eprive/Z80-MBC3/MBC2512.ods

Source: | MBC2512 Rev 3A
Date: | 14-4-2021
Tool: | Eeschema (5.1.4)-1
Ref | Value | Footprint
A1 | 20k | Potentiometer_THT:Potentiometer_Alpha_RD901F-40-00D_Single_Vertical
B1 | Piezo | Buzzer_Beeper:Sounder_17mm
C1 | 0.1uF | Capacitor_THT:C_Disc_D5.0mm_W2.5mm_P5.00mm
C2 | 0.1uF | Capacitor_THT:C_Disc_D5.0mm_W2.5mm_P5.00mm
C3 | 0.1uF | Capacitor_THT:C_Disc_D5.0mm_W2.5mm_P5.00mm
C4 | 0.1uF | Capacitor_THT:C_Disc_D5.0mm_W2.5mm_P5.00mm
C5 | 100uF | Capacitor_THT:CP_Radial_D6.3mm_P2.50mm
J1 | ANIN | Connector_PinHeader_2.54mm:PinHeader_1x03_P2.54mm_Vertical
J2 | Serial | Connector_PinSocket_2.54mm:PinSocket_1x06_P2.54mm_Vertical
J3 | Connector_01x12 | Connector_PinHeader_2.54mm:PinHeader_1x12_P2.54mm_Vertical
J4 | ICSP | Connector_PinHeader_2.54mm:PinHeader_1x03_P2.54mm_Vertical
J5 | SD_MOD | logos:PinSocket_1x06_P2.54mm_Vertical_Module_SDM
J6 | RTC-MOD | Connector_PinSocket_2.54mm:PinSocket_1x06_P2.54mm_Vertical_RTC
J7 | Conn_01x04_Male | Connector_PinHeader_2.54mm:PinHeader_1x04_P2.54mm_Vertical
L1 | LED – RED | LED_THT:LED_D5.0mm
L2 | LED – GREEN | LED_THT:LED_D5.0mm
L3 | LED – YELLOW | LED_THT:LED_D5.0mm
Q1 | 2N3905 or 2N3907 | Package_TO_SOT_THT:TO-92_Inline
R1 | 1k | Resistor_THT:R_Axial_DIN0207_L6.3mm_D2.5mm_P10.16mm_Horizontal
R2 | 680 | Resistor_THT:R_Axial_DIN0207_L6.3mm_D2.5mm_P10.16mm_Horizontal
R3 | 820 | Resistor_THT:R_Axial_DIN0207_L6.3mm_D2.5mm_P10.16mm_Horizontal
R4 | 33 | Resistor_THT:R_Axial_DIN0207_L6.3mm_D2.5mm_P10.16mm_Horizontal
R5 | 27k | Resistor_THT:R_Axial_DIN0207_L6.3mm_D2.5mm_P10.16mm_Horizontal
R6 | - | Resistor_THT:R_Axial_DIN0207_L6.3mm_D2.5mm_P10.16mm_Horizontal
R7 | - | Resistor_THT:R_Axial_DIN0207_L6.3mm_D2.5mm_P10.16mm_Horizontal
R8 | 100 | Resistor_THT:R_Axial_DIN0207_L6.3mm_D2.5mm_P10.16mm_Horizontal
R9 | 150 | Resistor_THT:R_Axial_DIN0207_L6.3mm_D2.5mm_P10.16mm_Horizontal
R10 | 22 | Resistor_THT:R_Axial_DIN0207_L6.3mm_D2.5mm_P10.16mm_Horizontal
R11 | 22k | Resistor_THT:R_Axial_DIN0207_L6.3mm_D2.5mm_P10.16mm_Horizontal
S1 | USER | Button_Switch_THT:SW_PUSH_6mm_H5mm
S2 | RESET | Button_Switch_THT:SW_PUSH_6mm_H5mm
U1 | Z80CPU | Package_DIP:DIP-40_W15.24mm_Socket_LongPads
U2 | TC551001BPL-70 | Package_DIP:DIP-32_W15.24mm_Socket_LongPads
U3 | ATmega4809-PF2 | Package_DIP:DIP-40_W15.24mm_Socket_LongPads
U4 | PCF8574 | Package_DIP:DIP-16_W7.62mm_Socket_LongPads
 | socket DIP32
 | socket DIP40
 | socket DIP40
 | socket DIP16
 | Battery | CR2032 or LIR2032
 | micro SD card
 | USB cable
