eprive/Z80-MBC3/Rev3A-2512.pdf

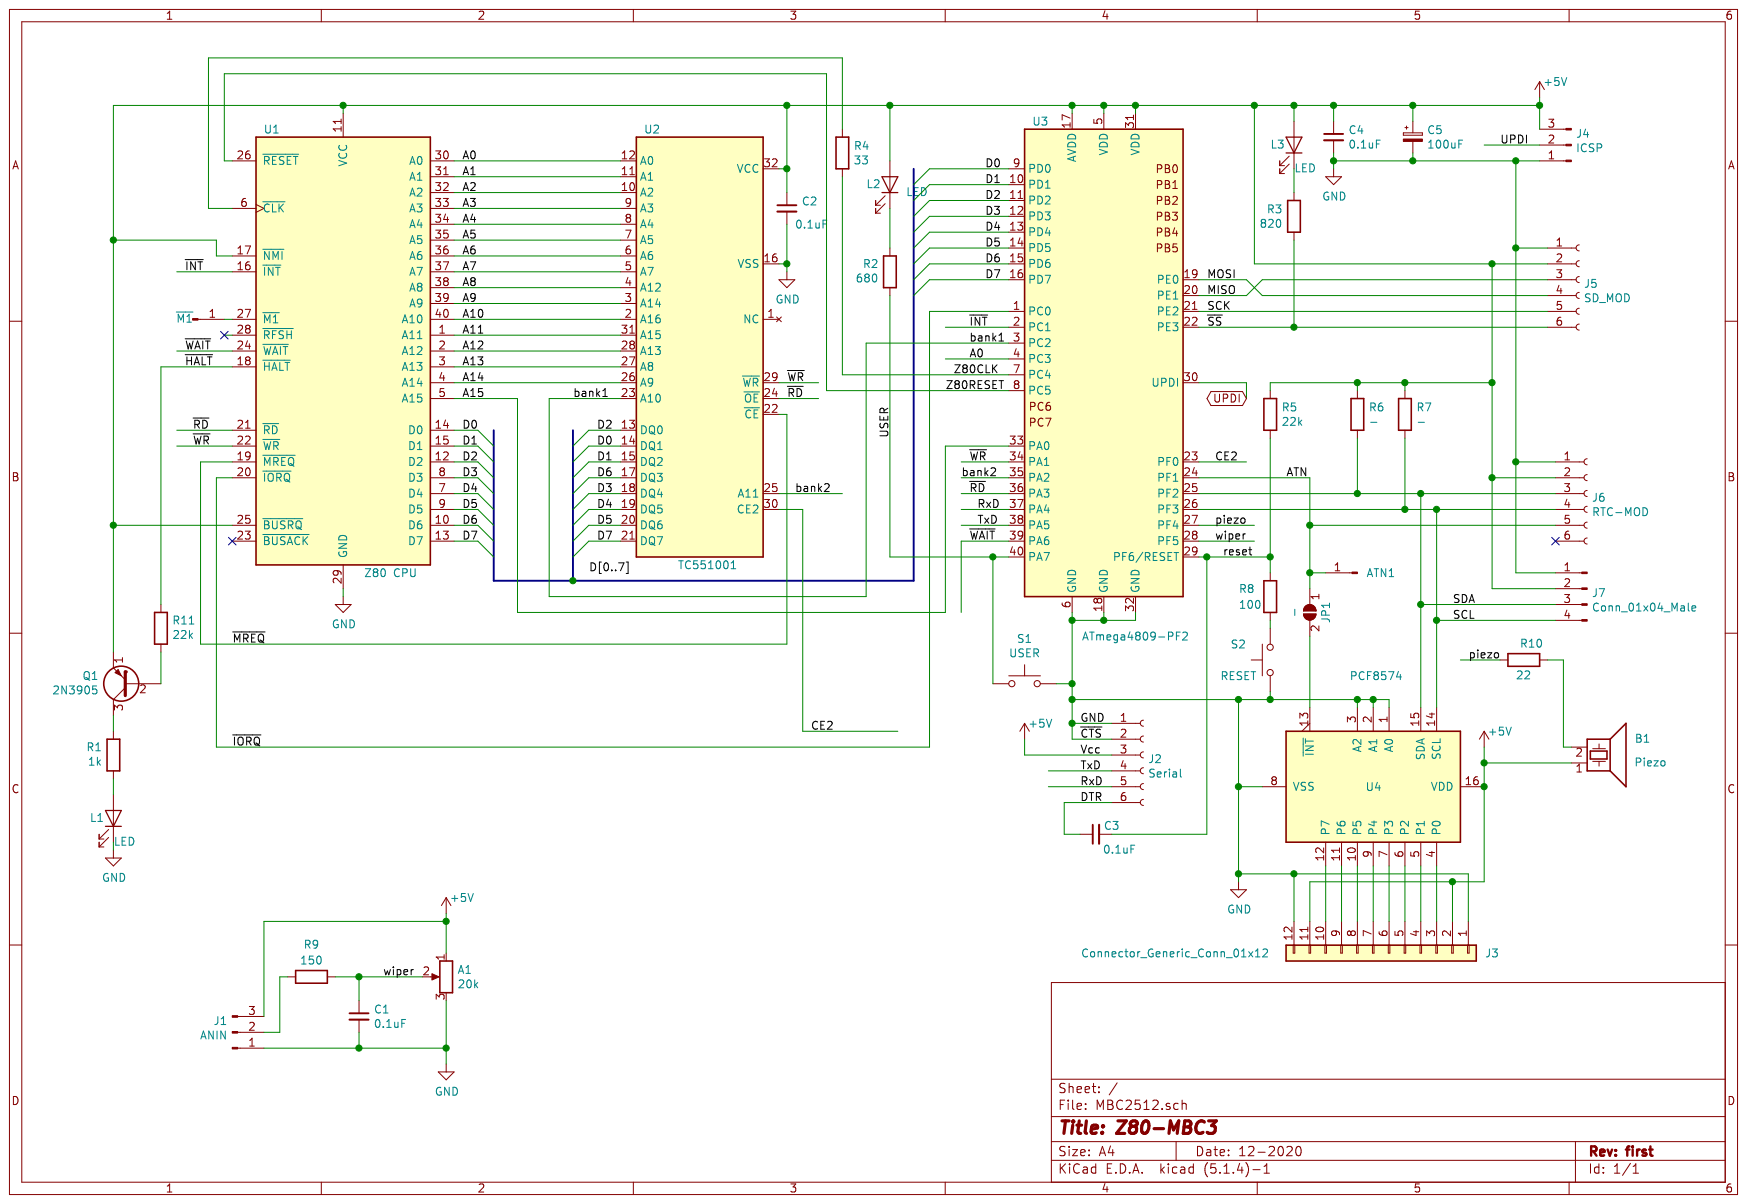
[picture p2: page 1]
