eprive/Z80-MBC3/MBC2512.sch

## KiCad design MBC2512.sch (2022-06-21, last stored version)

Schematic: MBC2512.sch

Parts:
A1: 20k; Potentiometer_Alpha_RD901F-40-00D_Single_Vertical
ATN1: PinHeader_1x01_P2.54mm_Vertical
B1: Piezo; Sounder_17mm
C1, C2, C3, C4: 0.1uF; C_Disc_D5.0mm_W2.5mm_P5.00mm
C5: 100uF; CP_Radial_D6.3mm_P2.50mm
J1: ANIN; PinHeader_1x03_P2.54mm_Vertical
J2: Serial; PinSocket_1x06_P2.54mm_Vertical
J3: Connector_Generic_Conn_01x12; PinHeader_1x12_P2.54mm_Vertical
J4: ICSP; PinHeader_1x03_P2.54mm_Vertical
J5: SD_MOD; PinSocket_1x06_P2.54mm_Vertical_Module_SDM
J6: RTC-MOD; PinSocket_1x06_P2.54mm_Vertical_RTC
J7: Conn_01x04_Male; PinHeader_1x04_P2.54mm_Vertical
JP1: -; SolderJumper-2_P1.3mm_Open_RoundedPad1.0x1.5mm
L1, L2: LED; LED_D5.0mm
L3: LED; LED_D5.0mm_YELLOW
Q1: 2N3905; TO-92_Inline
R1: 1k; R_Axial_DIN0207_L6.3mm_D2.5mm_P10.16mm_Horizontal
R2: 680; R_Axial_DIN0207_L6.3mm_D2.5mm_P10.16mm_Horizontal
R3: 820; R_Axial_DIN0207_L6.3mm_D2.5mm_P10.16mm_Horizontal
R4: 33; R_Axial_DIN0207_L6.3mm_D2.5mm_P10.16mm_Horizontal
R5, R11: 22k; R_Axial_DIN0207_L6.3mm_D2.5mm_P10.16mm_Horizontal
R6, R7: -; R_Axial_DIN0207_L6.3mm_D2.5mm_P10.16mm_Horizontal
R8: 100; R_Axial_DIN0207_L6.3mm_D2.5mm_P10.16mm_Horizontal
R9: 150; R_Axial_DIN0207_L6.3mm_D2.5mm_P10.16mm_Horizontal
R10: 22; R_Axial_DIN0207_L6.3mm_D2.5mm_P10.16mm_Horizontal
S1: USER; SW_PUSH_6mm_H5mm
S2: RESET; SW_PUSH_6mm_H5mm
U1: Z80 CPU; DIP-40_W15.24mm_Socket_LongPads
U2: TC551001; DIP-32_W15.24mm_Socket_LongPads
U3: ATmega4809-PF2; DIP-40_W15.24mm_Socket_LongPads
U4: PCF8574; DIP-16_W7.62mm_Socket_LongPads
~M1: PinHeader_1x01_P2.54mm_Vertical
