eprive/Z80-MBC3/(threads)

Thread 4 (2023-05-24):

Z80-MBC3 to assemble

hosamki, 2023-05-24:
I want to buy a Z80-MBC3 to assemble. What should I do?

hosamki, 2023-05-24:
I live in Seoul, South Korea.

eprive, 2023-05-24:
There is a webshop that is dedicated to the Z80-MBC3. You will find it here : https://eighties.company.site/

And you can choose the kit to be assembled, or a ready made and tested board.

You can use the email address ( eprive@gmx.com ) as mentioned under my account for future enquiries.

eprive

hosamki, 2023-05-30:
I tried to order on the site you told me, but it cannot be delivered to South Korea.
Why?

hosamki, 2023-05-30:
There is not South Korea (or Republic of Korea) in Country of Shipping & Delivery.

hosamki, 2023-05-30:
I sent you a email.

hosamki, 2023-05-31:
I checked that "Republic of Korea" was added to the list of countries.
So I just ordered and paid for two Z80-MBC3.
I look forward to receiving it as soon as possible.

Closed 2023-08-31.

Thread 5 (2023-06-21):

What should I do?

hosamki, 2023-06-21:
I've assembled Z80-MBC3 and tried to boot to putty, but it doesn't work. If you set it to serial mode and execute it, there is no message and it stops. What should I do?

hosamki, 2023-06-21:
![Uploading 1687353240239401466899661161486.jpg…]()

hosamki, 2023-06-21:
![Uploading 1687353296634833770379740911189.jpg…]()

hosamki, 2023-06-21:
When you connect, the blue LED flashes, but when you execute putty, it stops like this.

hosamki, 2023-06-21:
![Uploading 1687353669082373887100901091613.jpg…]()

hosamki, 2023-06-21:
Please help me!

Thread 7 (2024-05-05):

Kicad schematic lost symbol and cache

mciucci65, 2024-05-05:
Hi it's possible to have all symbol for kicad schematic or cache ?

eprive, 2024-05-05:
The complete set of Kicad design files is now in the repository at MBC2512.zip. The schematic, PCB layout, project specific items, and Gerber "plots".

Closed 2024-05-05.

Thread 8 (2024-06-01):

atmega4809 programming

mciucci65, 2024-06-01:
thanks again for uploading gerber and  etc.
I have successfully programmed the atmega4809 with Arduino Uno and Jtag2updi.
I programmed the chip 4809 with flash.bat and result is successfully programmed.
The Program compare.bat tells me that flash compared with ios hex file is ok  but when I start with a CPU Z84C0020PEC, working on MBC2,  the Halt LED turn on and nothing happens and the CPU warms up. If I start without cpu I don't see anything while with the MBC2 at least I see the boot of the mega32a chip.
I checked also with oscilloscope the cpu clock and it is 5mhz.
There is something wrong that I am doing to program the 4809 chip needing a bootloader and specific value for fuses ?

eprive, 2024-06-01:
Your question raises several other questions, MBC2 or MBC3 ? Only ATmega4809 chips that are contained in the (complete) Z80-MBC3 kit or assembled boards will function. Other (blank) ATmega4809-PF's cannot be used.
And they are unsuitable for the older Z80-MBC2. As are derivatives or attempts to clone the Z80-MBC3.

Closed 2024-06-01.

Thread 9 (2024-08-16):

Support

mciucci65, 2024-08-16:
Can you explain me better how to use external i2c bus and what is the meaning of JP1 connected to INT signal of i2c GPIO controller and share some code example ?.

Can you ask Carlo Consoli to share the code for LCD display?

Is it possible to share the sketch? I want to implement a status display controlled by i2c bus.

eprive, 2024-08-16:
The way to use the I2C bus with the Z80-MBC3 is described in the application note : AN-GPIOandI2C.pdf

The on board PCF8574 is fixed at adress 0x20. External expansion with additional PCF8574 or MCP23017 should be set at other unique addresses. Standard LCD modules are available which have their own PCF8574 on a piggyback addon.
JP1 is unconnected and not used. It would be possible to have external interrupts when needed for customised applications.

I understand that Carlo Consoli has shared his code and I can ask him to post it on the Facebook group page or email it to you. This applies to all sample code created by Z80-MBC3 users.

The Z80-MBC3 is not an Arduino compatible board but one for Z80 applications, and DIY assembly of a single board computer. The ATmega4809 IOS controller currently does not implement a "sketch" as was the case with the Z80-MBC2.

In answer to you last note : If your type of application is a simple status display, or one with a GPIO expansion, then your are advised to use a Arduino module, or cloned Arduino board.  With these you can implement the desired "sketch" and use the Arduino libraries.

mciucci65, 2024-08-17:
if I understand correctly you advise me to use an arduino as an I2C slave which in turn controls the 1602 display connected to the same i2c bus.
but which C library do I have to use on the board to interface and send the command to the I2C bus? Arduini use Wire.h
I simulate with Arduino as master and another Arduino as slave:

MASTER:
#include <Wire.h>           // Include the Wire library for I2C communication

const int SLAVE_ADDRESS = 0x08;  // Define the I2C address of the slave
String messageToSend = "Hello, Arduino!";  // Message to send to the slave

void setup() {
  Wire.begin();  // Initialize the I2C as master
  Serial.begin(9600); // Initialize serial communication for debugging
}

void loop() {
  Wire.beginTransmission(SLAVE_ADDRESS); // Start communication with the slave
  Wire.write(messageToSend.c_str());     // Send the message
  Wire.endTransmission();                // End the transmission

  Serial.println("Message sent to slave: " + messageToSend);

  delay(1000);  // Wait for a second before sending the next message
}
SLAVE:
#include <Wire.h>                // Include the Wire library for I2C communication
#include <LiquidCrystal_I2C.h>   // Include the library for the I2C LCD

const int SLAVE_ADDRESS = 0x08;  // Define the I2C address for the slave

LiquidCrystal_I2C lcd(0x27, 16, 2); // Set the LCD I2C address (0x27 is common) and size

String receivedMessage = "";      // Variable to store received message

void setup() {
  Wire.begin(SLAVE_ADDRESS);      // Initialize the I2C as slave
  Wire.onReceive(receiveEvent);   // Register the receive event function

  lcd.init();                     // Initialize the LCD
  lcd.backlight();                // Turn on the backlight

  lcd.clear();                    // Clear the LCD screen
  lcd.setCursor(0, 0);            // Set cursor to first row, first column
  lcd.print("Waiting for msg");   // Display initial message
}

void loop() {
  if (receivedMessage.length() > 0) {
    lcd.clear();                  // Clear the previous message
    lcd.setCursor(0, 0);          // Set cursor to the first row
    lcd.print("Received:");       // Print a static message
    lcd.setCursor(0, 1);          // Move cursor to the second row
    lcd.print(receivedMessage);   // Print the received message

    receivedMessage = "";         // Clear the message after displaying
  }
}

// Function to be called when data is received from the master
void receiveEvent(int bytesReceived) {
  receivedMessage = "";  // Clear the previous message

  while (Wire.available()) {
    char c = Wire.read();   // Read each byte and append to the message
    receivedMessage += c;
  }
}

Closed 2024-08-17.

Thread 10 (2025-02-08):

IOS works, but no program/os works

gmu-code, 2025-02-08:
After i boot the system it displays on Putty:

```
Z80-MBC3. IOS (ATmega4809) - release S40427

IOS: GPIO with PCF8574 or MCP23017 is enabled
IOS: CP/M Autoexec is ON
IOS: Select boot mode or system parameters:
 0: No change (2)
 1: Autoboot
 2: Basic
 3: Forth
 4: Load OS from Disk Set 0 CP/M 2.2
 5: iHex Loader
 6: Change Z80 clock speed (-> 10 MHz)
 7: Toggle CP/M Autoexec (-> OFF)
 8: Change Disk Set 0 CP/M 2.2
 9: Edit RTC date + time
Enter your choice >

```
The red LED is on, the blue is blinking.
If i select one of the choices 2, 3, 4 or 5 as sample here "**3 Forth**" it displays:

```
IOS: Loading boot program (FORTH13.BIN)...
IOS: Z80 clock speed set to 5 MHz
```
All LEDs are off.
There is no response over Putty.

On "**2 Basic**"

```
IOS: Loading boot program (BASIC47.BIN)...
IOS: Z80 clock speed set to 5 MHz

```
The red LEDs is on.
There is no response over Putty.

Are you any idea - is it a typical error who can be resolved?

Thanks.

pa3esb, 2025-02-08:
I once had a Z80 that was very dirty. After months of non use it didn’t work any more. Cleaning with alcohol helped to solve the problem.

gmu-code, 2025-02-08:
@eprive
Thanks for this information.
I will check it.

@pa3esb
Thanks for this hint - but my Z80 is not dirty :-)
It's look like new.

pa3esb, 2025-02-08:
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

This is how dirty my Z80 was.  Clearly a chip that had been in storage for a long time. And as it became a bit wet it shorted the signals to ground. Cmos has very high impedance.

Thread 11 (2025-04-20):

Booting Fuzix from disk set 5

twi42, 2025-04-20:
Z80-MBC3 arrived and was easy to assemble as promised. Everything else worked as documented, but I wanted to try Fuzix using the more recent sdcard image (SD-S220718-R290823-v2) for MBC2.

The image works like the preinstalled sdcard (s220718-r240620_sd_v1) but the IOS still only shows 4 disk sets and no Fuzix visible, even though the card has DS5N01.DSK and DS5NAM.DAT accordingly.

Booting Fuzix via autoboot results immediate crash, apparently due to missing disk mappings.

It's likely something simple, but I'd appreciate a hint.

eprive, 2025-04-20:
This is not unexpected behavior, since Fuzix was released for the Z80-MBC2. Fuzix requires modifications to the IOS. Such a modification was not implemented in the IOS for the Z80-MBC3, which prevents Fuzix from booting. Although such a modification may be possible, I see no practical advantage or useful application in relation to the effort required to realise it.
As far as I know, Fuzix is   a very limited emulation of a Linux like console terminal without examples.

Any practical application could be made more efficient and simpler with the available languages   and disksets.

For this reason, the IOS for Fuzix was not implemented for the MBC3. If someone can provide arguments for its usefulness, I will reconsider implementing such a feature. It is probably just as useful as Collapse OS.

twi42, 2025-04-20:
Thank you for the comprehensive explanation - after looking into Fuzix bit deeper I came to the same conclusion. Also just to understand, adding any additional entries to the diskset menu requires support from IOS? I'm current checking if I can run a Mobitex terminal ROM from 1992 (32K) and see the original debug output.

eprive, 2025-04-21:
You can substitute one of the available disksets with another set. The naming is retrieved from the SD file.

Closed 2025-04-21.
