eprive/Z80-MBC3/(commit log)

2021-04-14 Add files via upload
    Schematic of the Z80-MBC3 Rev. 3A board
2021-04-14 Add files via upload
    Bill of Materials ; components
    [MBC2512.ods]
2021-12-13 Using the onboard digital outputs of the Z80-MBC3
    The Z80-MBC3 has two digital outputs on the PCB that can be used as a status or warning indicator to the user. The green LED labeled "LAMP" not only lights up when the USER button is pressed, but can also be turned on and off as instructed in a Z80 application.
    And then there's the beeper that issues a short beep when a <BELL> character is sent to the terminal. A simple statement in BASIC demonstrates this with : PRINT CHR$(7).
    But it is also possible to beep with variable duration. This Application Note documents these features.
2021-12-13 how to program the LAMP and beeper outputs
    The Z80-MBC3 has two digital outputs on the PCB that can be used as a status or warning indicator to the user. The LED labeled "LAMP" not only lights up when the USER button is pressed, but can also be turned on and off per instruction in a Z80 application.
    And there's the beeper that issues a short beep when a <BELL> character is sent to the terminal. A simple statement in BASIC demonstrates this with : PRINT CHR$(7).
    But it is also possible to beep with variable duration. How this can be programmed is described in this Application Note.
2022-06-21 Value of R10 has changed to 22 Ohm.
    The former value of 68 Ohm works with most sounders. However, the sound can be unclear with some parts. 22 Ohm is more stable.
2022-06-21 Value of R10 has changed to 22 Ohm.
    [MBC2512.ods]
2022-06-21 KiCAD schematic source file of the Z80-MBC3
    as per request / issue
    [MBC2512.sch]
2023-01-04 Read this before you pick up your soldering iron.
    Hints ans tips for those who have bought a kit for self assembly of the Z80-MBC3. Explanation of the design changes for this revision of the Multi Boot Computer.
2023-01-04 Read this before picking up your soldering iron.
    Hints and tips for the self assembly of the Z80-MBC3 kit computer with an explanation of some design choices, its quirks and limitations.
2023-02-17 How to use the onboard GPIO or externals via the I2C bus
    This application note describes the addressing method of the onboard PCF8574 circuit for general purpose input output (GPIO). And the general addressing scheme to use other peripherals connected to the I2C port of the Z80-MB3. You can add external PCF8574 circuits to expand the number of I/O pins, replace the onboard PCF8574 with an external MCP23017, and/or expand the input output functions with other I2C modules.
2023-03-05 An update release (S30216) of the IOS firmware
    This release has added Xon-Xoff flow control on the serial port. It enables the transfer of larger files while protecting buffer overflows.
    Also fixed is the GPIO input read function. And USER button now works properly with a blue coloured LED on the LAMP position.
2023-04-05 Update README.md
    The first batch of kits is sold out, and the kits and assembled boards are now listed for sale on multiple platforms ( eBay (nl / de / fr) , tindie.com, and Marktplaats.nl.
2023-08-29 Update release (S30831) of IOS firmware for xmodem
    Issues fixed in this release :
    1) Compatibility for the purpose files transfers with xmodem.com is restored ; there is no Xon - Xoff flow control anymore in the IOS firmware
    2) RESET by <BREAK> signal from the keyboard, and <Esc> into the boot menu for IOS settings can now be called from the keyboard.
    This has the same function as the buttons on the Z80-MBC3 PCB, but you can use these as an alternative without the need to operate the on board buttons.
2024-04-27 Release without XON-OFF flow and a bug fix
    The version released in 2023 still had a minor bug which controlled the LAMP LED. It could not be turned off by command. This IOS function 0 was repaired.
2024-05-05 KiCAD design files, schematic, and PCB Gerbers
    The complete set of design files for the Z80_MBC3 Version 3A. Includes project specific cache, and Gerbers of the PCB.
2024-05-05 Delete MBC2512.sch
    MBC2512.zip is now included and has the KiCAD design files
    [MBC2512.sch]
